javicarrera/Mis-Impresoras3D/Archivos-originales/Melzi board 2.0/melzi-master/README

Melzi Ardentissimo
Based on Sanguinololu

Schematic and board files.

http://reprap.org/wiki/Melzi
