javicarrera/Mis-Impresoras3D/Archivos-originales/README.md

# Archivos originales

Archivo originales de la impresora:
- Instrucciones
- Montaje
- Listado de componentes
- Firmware original
