javicarrera/Mis-Impresoras3D/Cura-perfiles/README.md

# Perfiles de Cura

Perfiles personales para Cura
