javicarrera/Mis-Impresoras3D/Mejoras/README.md

# Mejoras

Mejoras hechas en la impresora, incluyendo piezas 3D y modelos.
Lista de Hardware que lleva montada la impresora, incluyendo
