javicarrera/Mis-Impresoras3D/Modelo3D/README.md

# Modelos 3D

Modelos 3D de la impresora y sus modificaciones
