javicarrera/Mis-Impresoras3D/Archivos-originales/Melzi board 2.0/Melzi-pcb.png

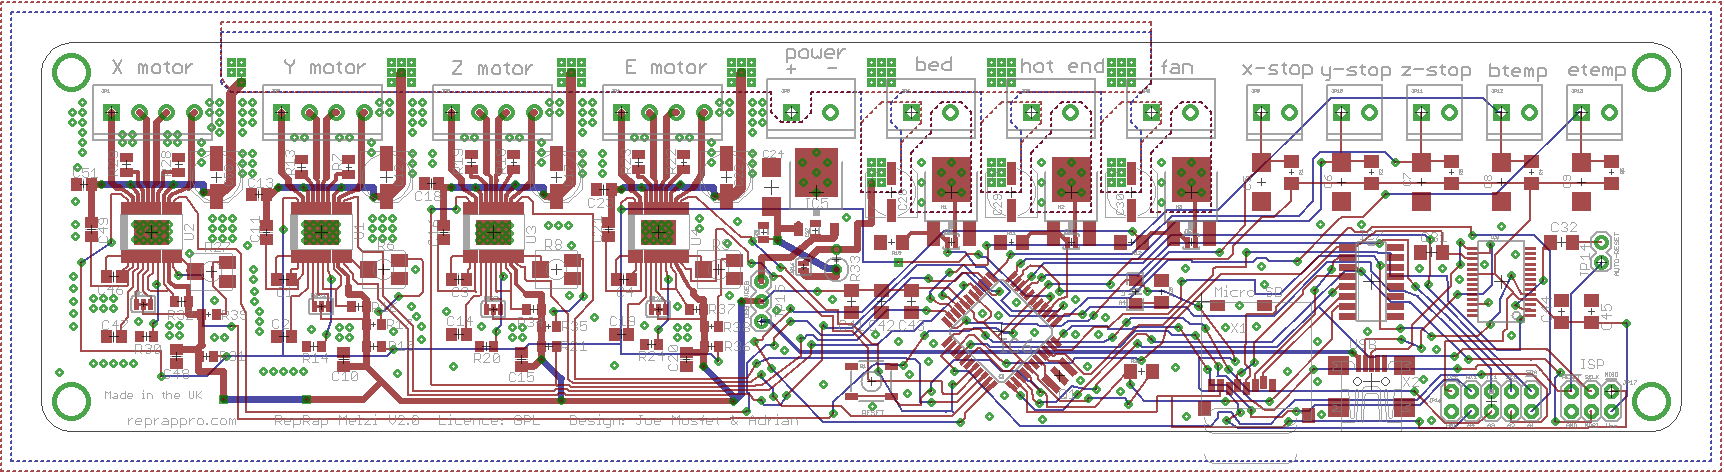
Archivos-originales/Melzi board 2.0/Melzi-pcb.png
