javicarrera/Mis-Impresoras3D/Archivos-originales/X1 Part List(1).pdf

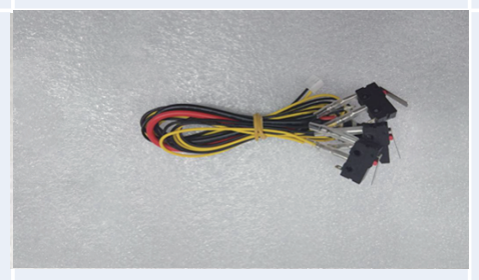
[picture p13: figure]

No. | Picture | Details | Quantity | Check | No. | Picture | Details | Quantity | Check
1-1 | | Limit switch | 3 | | 1-2 | | DC power jack | 1

# X1 Part List

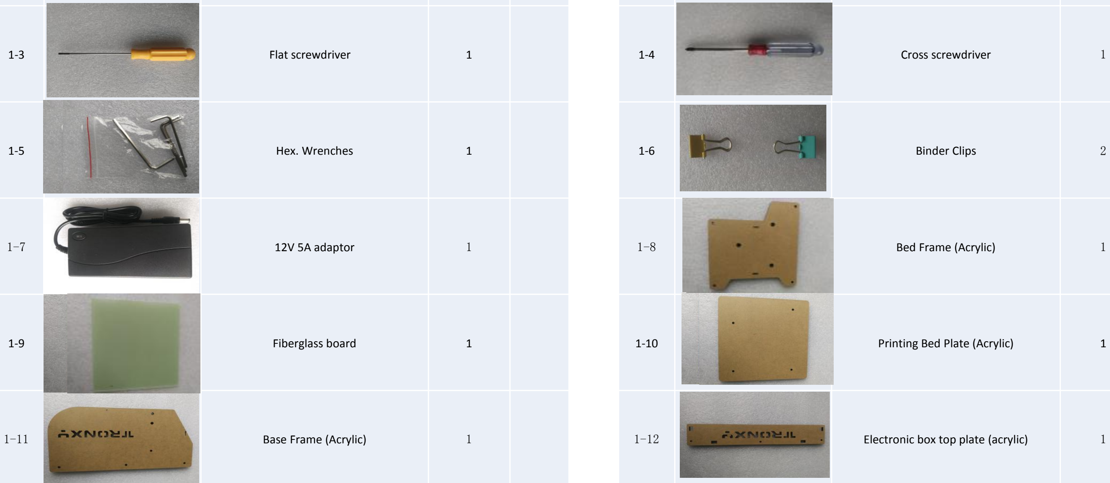
[picture p14: figure]
Flat screwdriver; Cross screwdriver; Hex. Wrenches; Binder Clips; 12V 5A adaptor; Bed Frame (Acrylic); Fiberglass board; Printing Bed Plate (Acrylic); Base Frame (Acrylic); Electronic box top plate (acrylic)
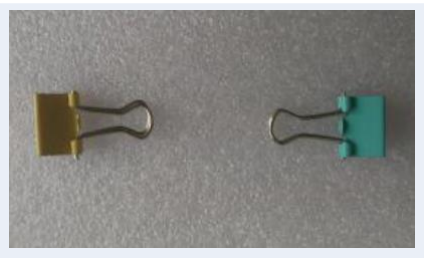
[picture p15: figure]
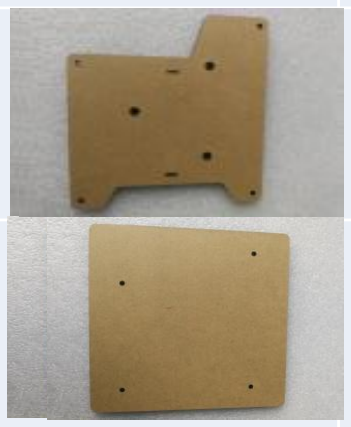
[picture p16: figure]
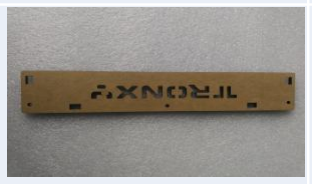
[picture p17: figure]

No. | Picture | Details | Quantity | Check | No. | Picture | Details | Quantity | Check
1-13 | | Electronic box Back plate (acrylic) | 1 | | 1-14 | | Electronic box bottom plate (acrylic) | 1
1-15 | | Electronic box front plate (acrylic) | 1 | | 1-16 | | LCD cable | 1

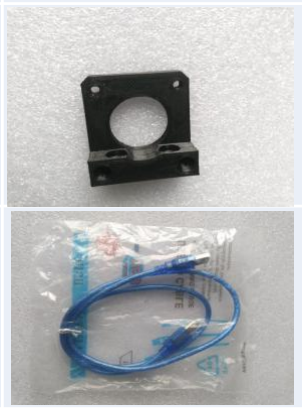
[picture p18: figure]

1-17 | | Electronic box side plate (acrylic) | 2 | | 1-18 | | Z-motor seat | 1
1-19 | | Card reader & Micaro SD card | 1 | | 1-20 | | USB cable | 1
1-21 | | X-motor mount (acrylic) | 1
2-1 | | Extruded bracket | 1 | | 2-2 | | Screws kits | 1
2-3 | | Motor wires | 4 | | 2-4 | | Small acrylic kits | 1

No. | Picture | Details | Quantity | Check | No. | Picture | Details | Quantity | Check

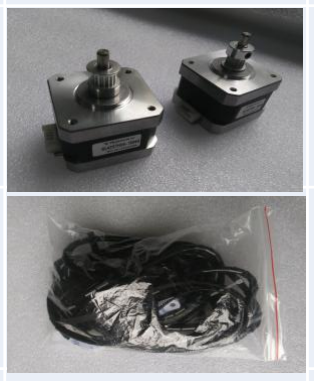
[picture p19: figure]

2-5 | | Z-axis motor (with coupling) | 1 | | 2-6 | | X-axis & Y-axis motors (With Pulley) | 2
2-7 | | Extruder (assembled) | 1 | | 2-8 | | Timing belt x 2pcs Winding pipe Cable ties | 1

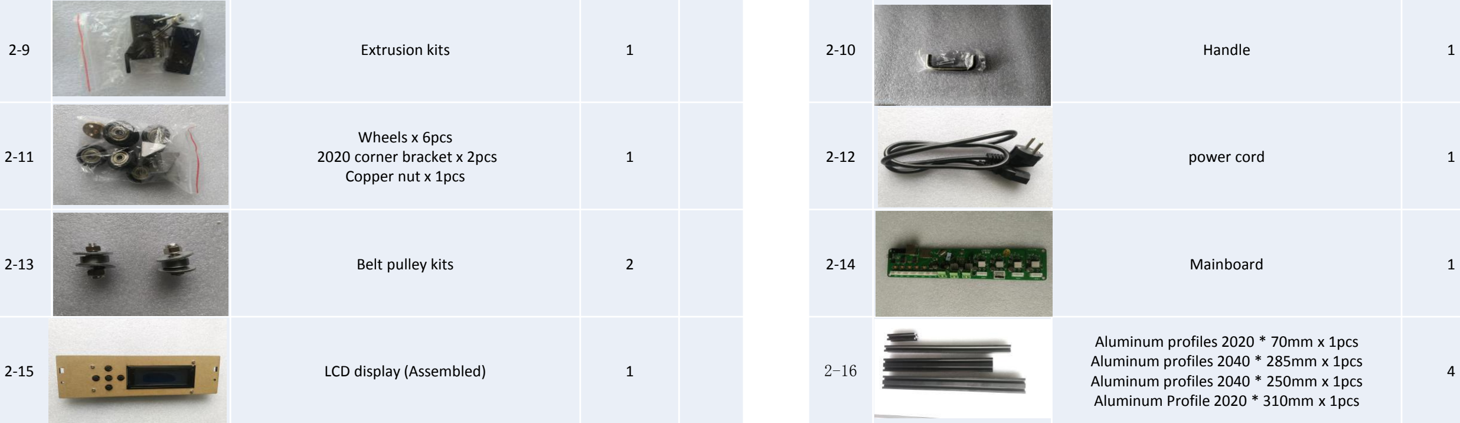
[picture p20: figure]
Extrusion kits; Handle; Belt pulley kits; Mainboard

2-11 | | Wheels x 6pcs 2020 corner bracket x 2pcs Copper nut x 1pcs | 1 | | 2-12 | | power cord | 1

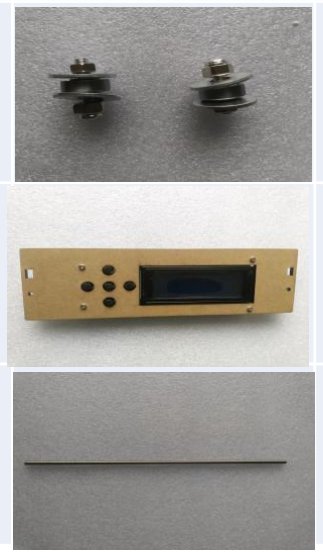
[picture p21: figure]

2-15 | | LCD display (Assembled) | 1 | | 2-16 | | Aluminum profiles 2020 * 70mm x 1pcs Aluminum profiles 2040 * 285mm x 1pcs Aluminum profiles 2040 * 250mm x 1pcs Aluminum Profile 2020 * 310mm x 1pcs | 4
2-17 | | Threaded Rod | 1 | | 2-18 | | Extrusion motor(with gear) | 1
