javicarrera/Mis-Impresoras3D/Archivos-originales/20mm_box_pillar.stl

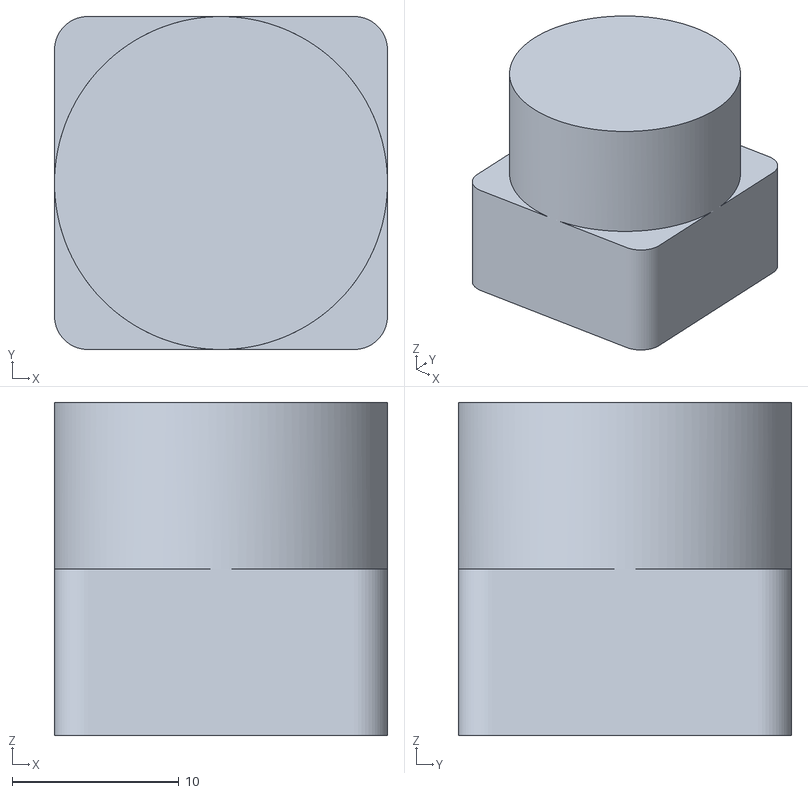
[picture p22: CAD file, 2021-08-16]
Archivos-originales/20mm_box_pillar.stl
20.0 x 20.0 x 20.0
