javicarrera/Mis-Impresoras3D/(list of files, cad)

Other CAD files:
Cura-perfiles/TronXY 45mm-s 0.3mm NoSupport.3mf
Cura-perfiles/TronXY 30mm-s 0.3mm.3mf
