javicarrera/Mis-Impresoras3D/Archivos-originales/Melzi board 2.0/Using an Arduino to Flash the Melzi Board (Wanhao I3) and Upgrade Firmware_ 3 Steps.pdf

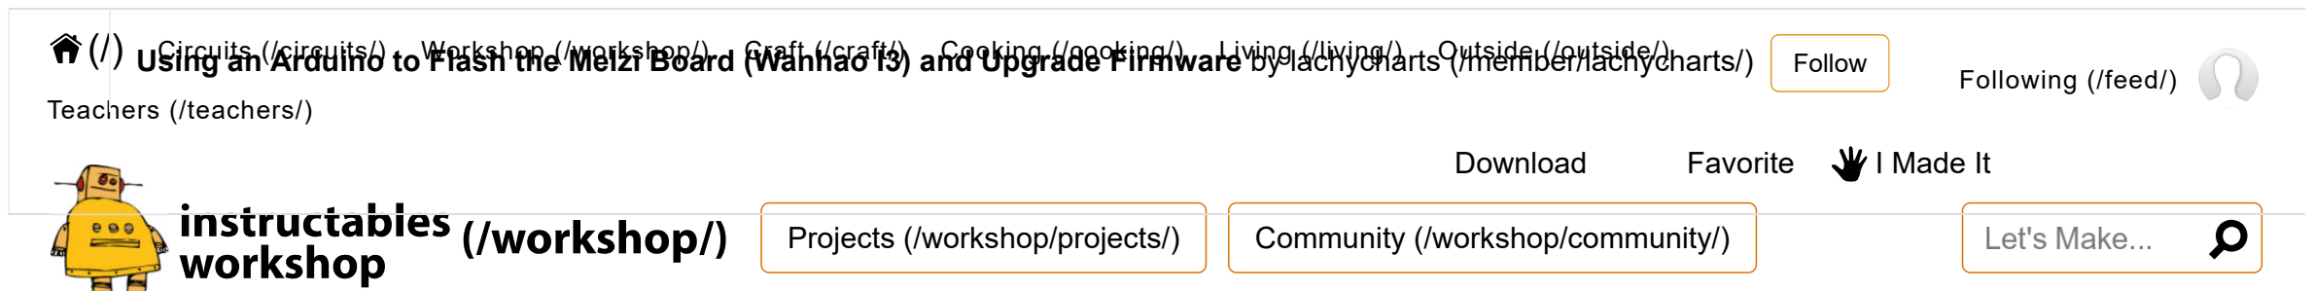
[picture p51: figure]
Circuits (/circuits/); Workshop (/workshop/); Craft (/craft/); Cooking (/cooking/); Living (/living/); Outside (/outside/); Teachers (/teachers/); Following (/feed/); Projects (/workshop/projects/); Community (/workshop/community/); Download; Favorite; I Made It

Published Dec 29th, 2016 | Download | | Favorite

# Using an Arduino to Flash the Melzi Board (Wanhao I3) and Upgrade Firmware

By lachycharts (/member/lachycharts/) in Workshop (/workshop/) > 3D Printing (/workshop/3d-printing/projects/) | 18.678 | 25 | 19

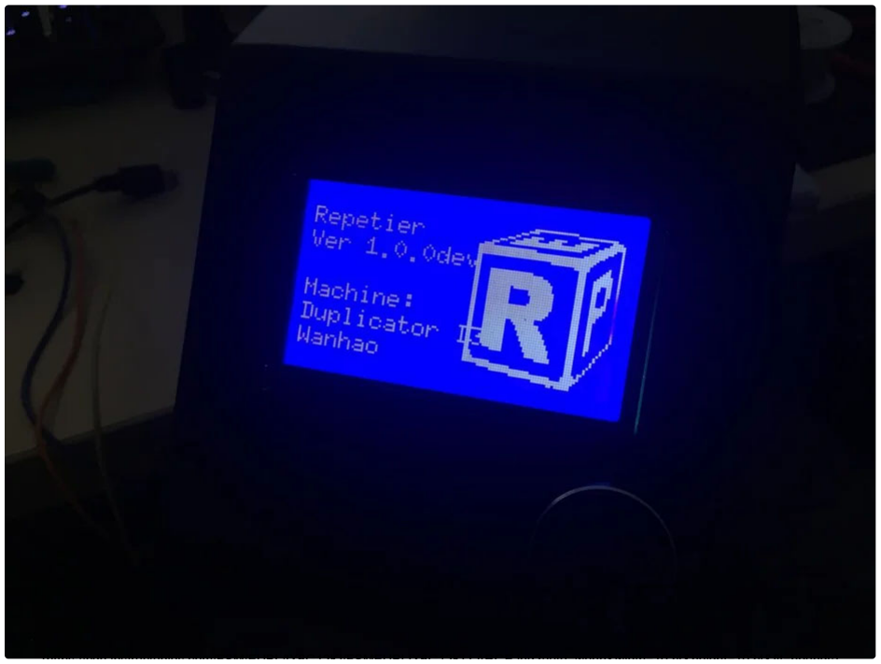
[picture p52: figure]
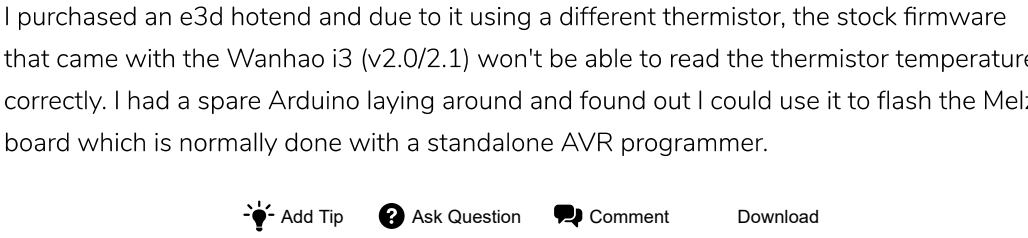
[picture p53: figure]
Add Tip; Ask Question; Comment; Download

# Teacher Notes

### Add Teacher Note

(https://cdn instructables com/FSM/EUBL/IX6G12KI/FSMEUBLIX6G12KI LARGE jpg?auto=webp&width=1024&height=1024&fit=bounds)

Using an Arduino to Flash the Melzi Board (Wanhao I3) and Upgrade Firmware by lachycharts (/member/lachycharts/) Follow

Using an Arduino to Flash the Melzi Board (Wanhao I3) and Upgrade ... | https://www.instructables.com/id/Using-an-Arduino-to-Flash-the-Melz...
1 de 8 | 15/12/2019 16:01

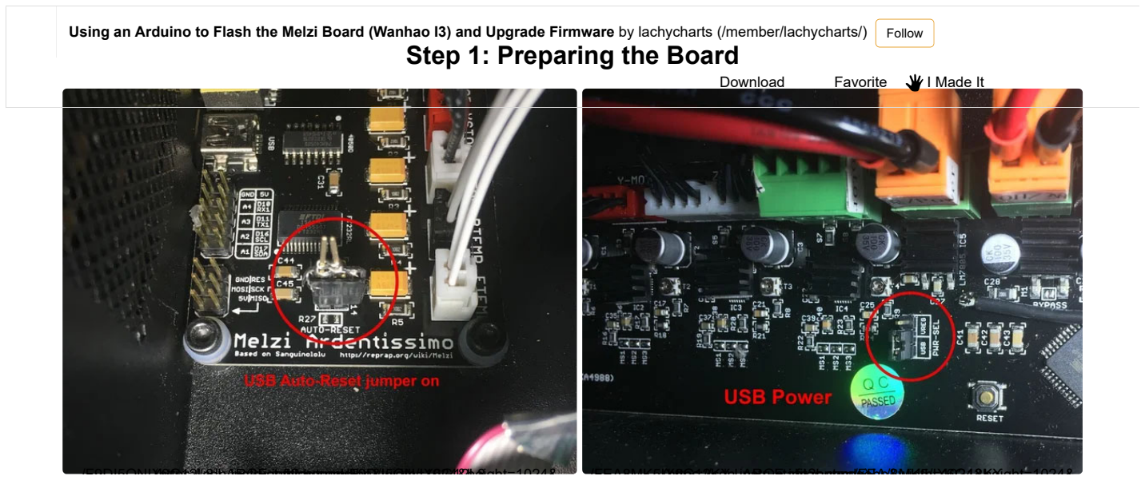
[picture p54: figure]
Step 1: Preparing the Board
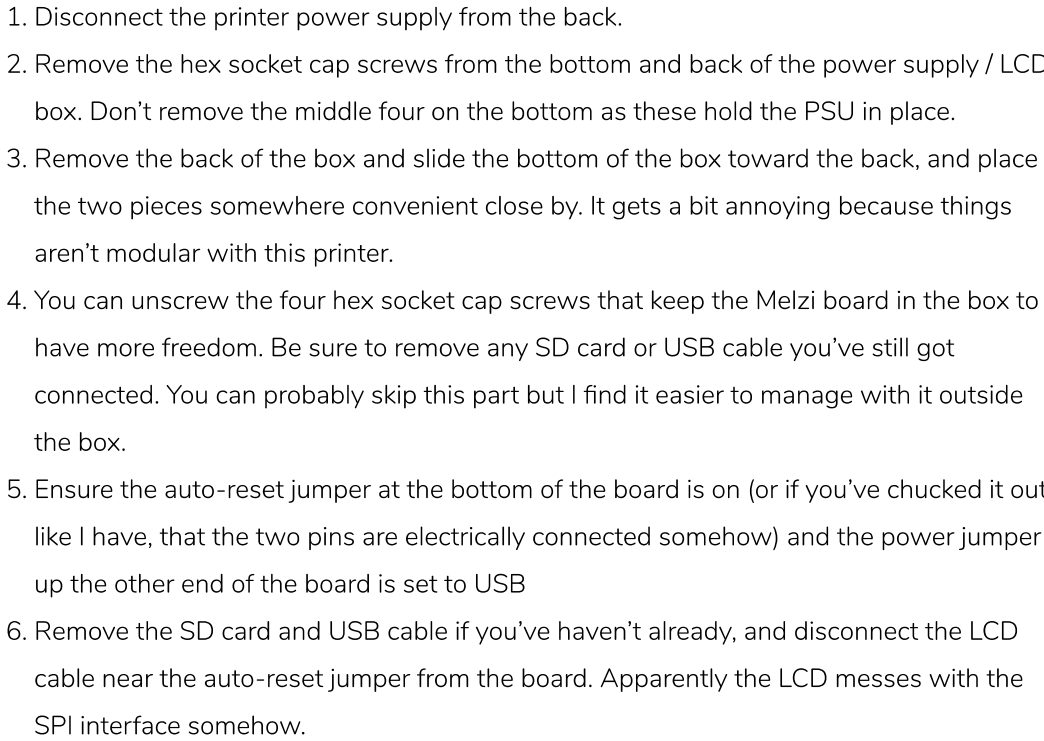
[picture p55: figure]

# Step 2: Preparing the Arduino

/F9DI5ONIX6G12L8 LARGE jpg? (https://cdn instructables com/F9D/I5ON/IX6G12L8 fit=bounds auto=webp&width=1024&height=1024& ) | /FEA8MK5IX6G12KX LARGE jpg?auto (https://cdn instructables com/FEA/8MK5/IX6G12KX fit=bounds =webp&width=1024&height=1024& )
Add Tip | Ask Question | Comment | Download

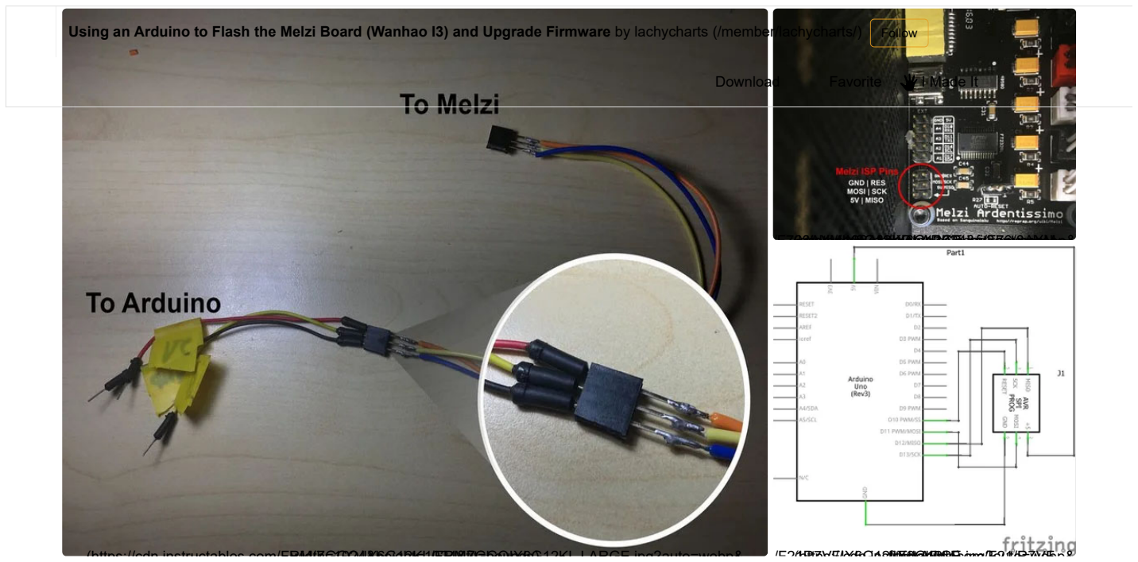
[picture p56: figure]

(https://cdn instructables com/FRM/ZGGQ/IX6G width=1024&height=1024&fit=bounds 12KL/FRMZGGQIX6G12KL LARGE jpg?auto=webp& )

/F768AXMIX6G12KP LARGE jpg?auto=webp& (https://cdn instructables com/F76/8AXM width=1024&height=1024&fit=bounds /IX6G12KP | )

/F21R7VFIX6G12LE LARGE jpg?auto=webp& (https://cdn instructables com/F21/R7VF fit=bounds /IX6G12LE)

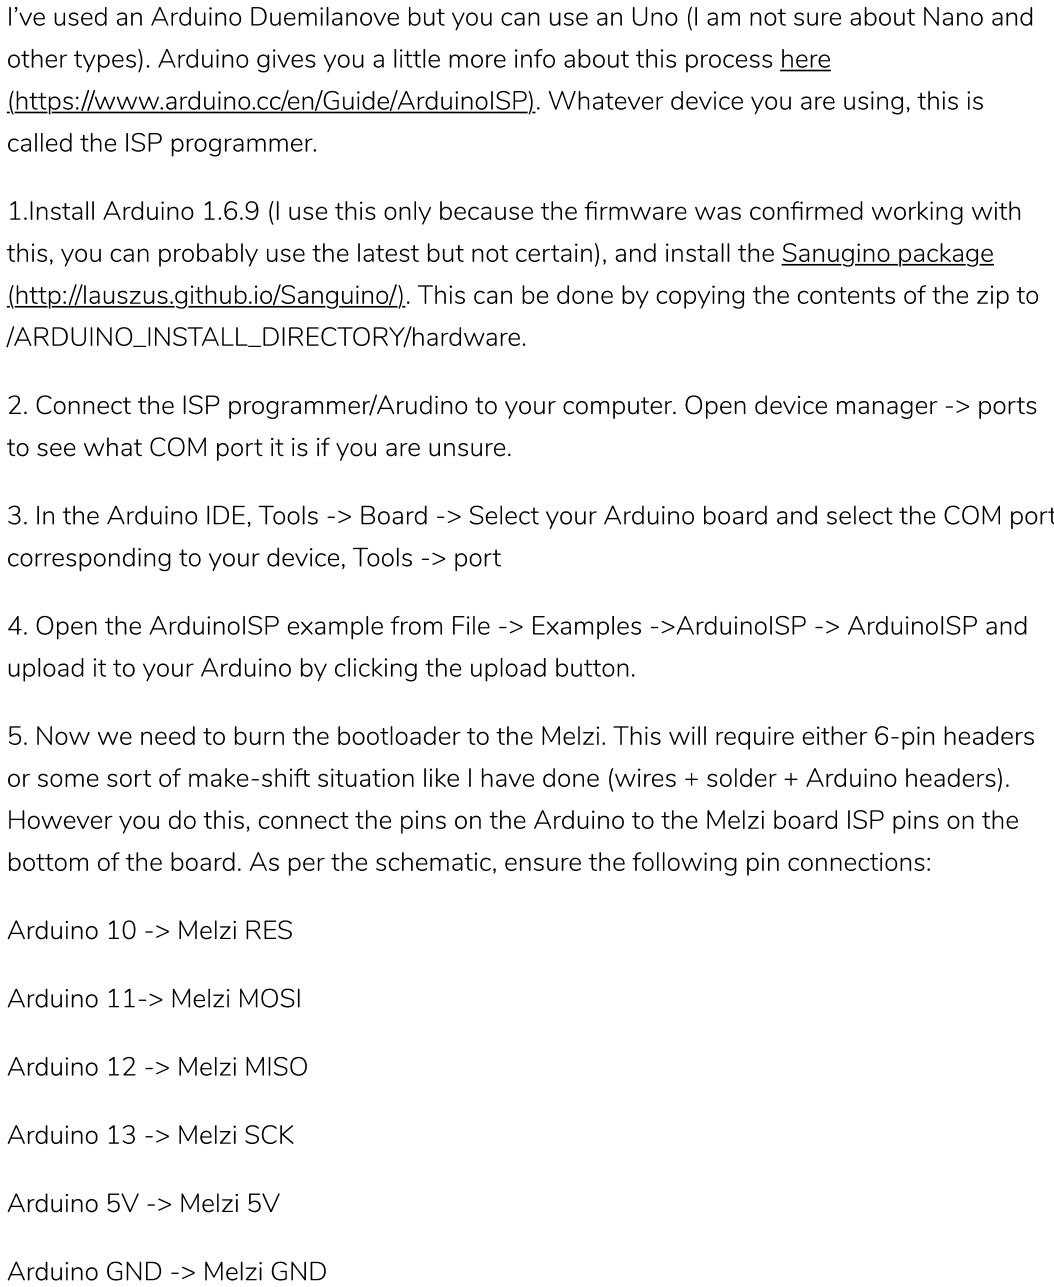
[picture p57: figure]

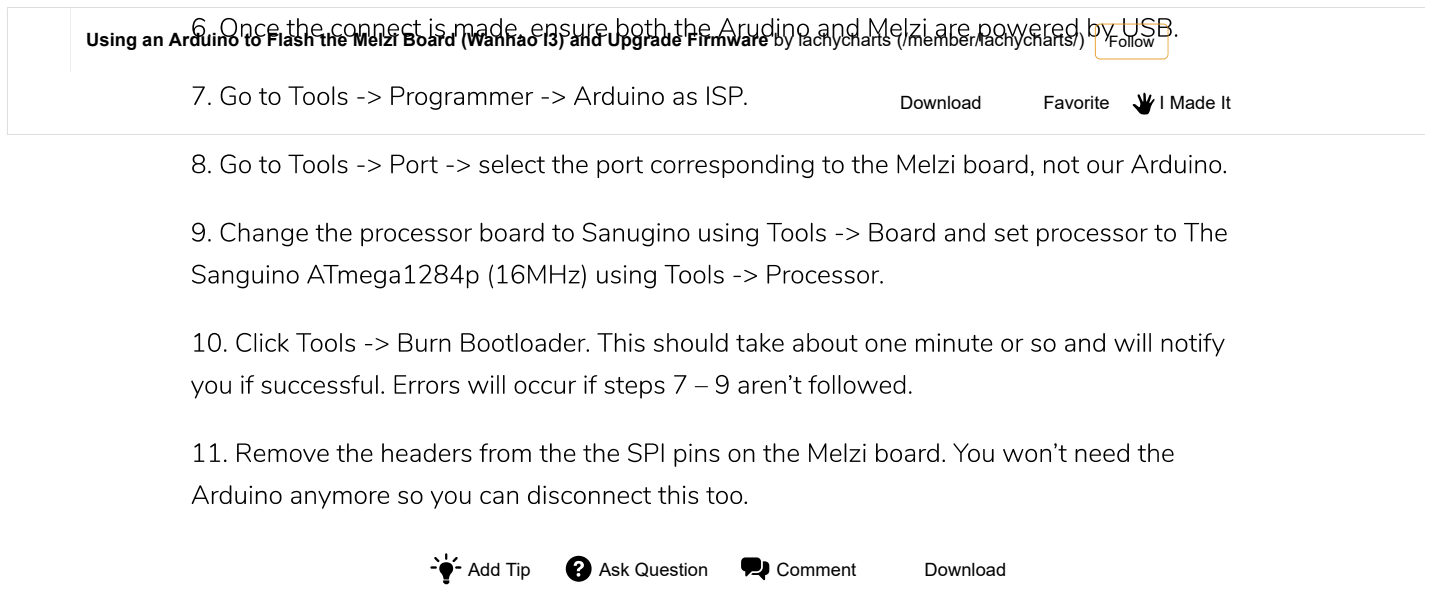
[picture p58: figure]
Add Tip; Ask Question; Comment; Download

# Step 3: The Firmware

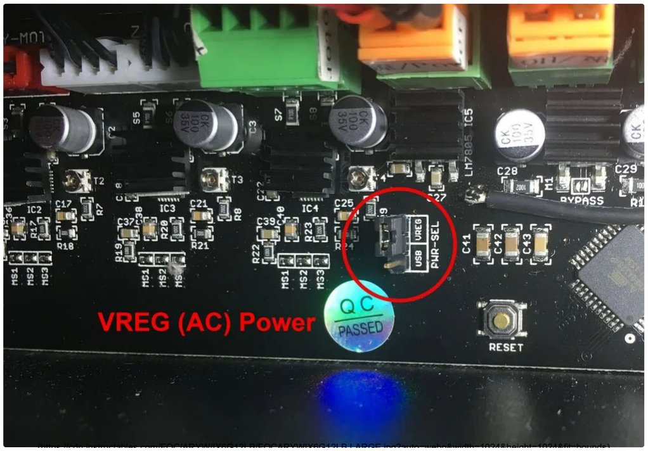
[picture p59: figure]

(https://cdn instructables com/FOC/ARYW/IX6G12LB/FOCARYWIX6G12LB LARGE jpg?auto=webp&width=1024&height=1024&fit=bounds)

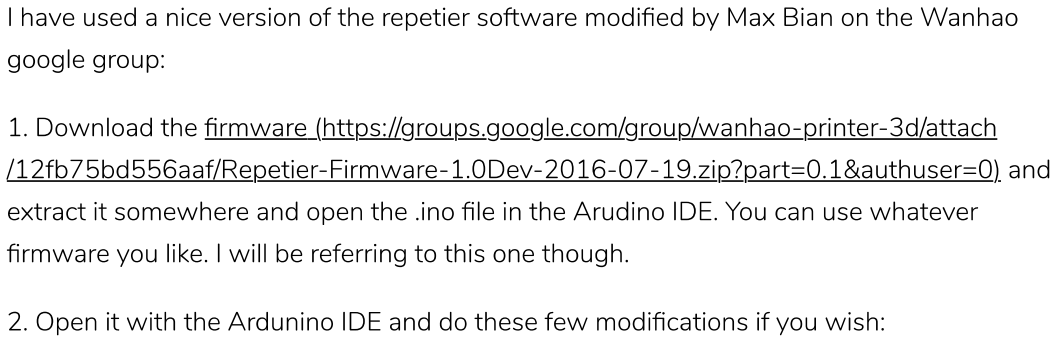
[picture p60: figure]
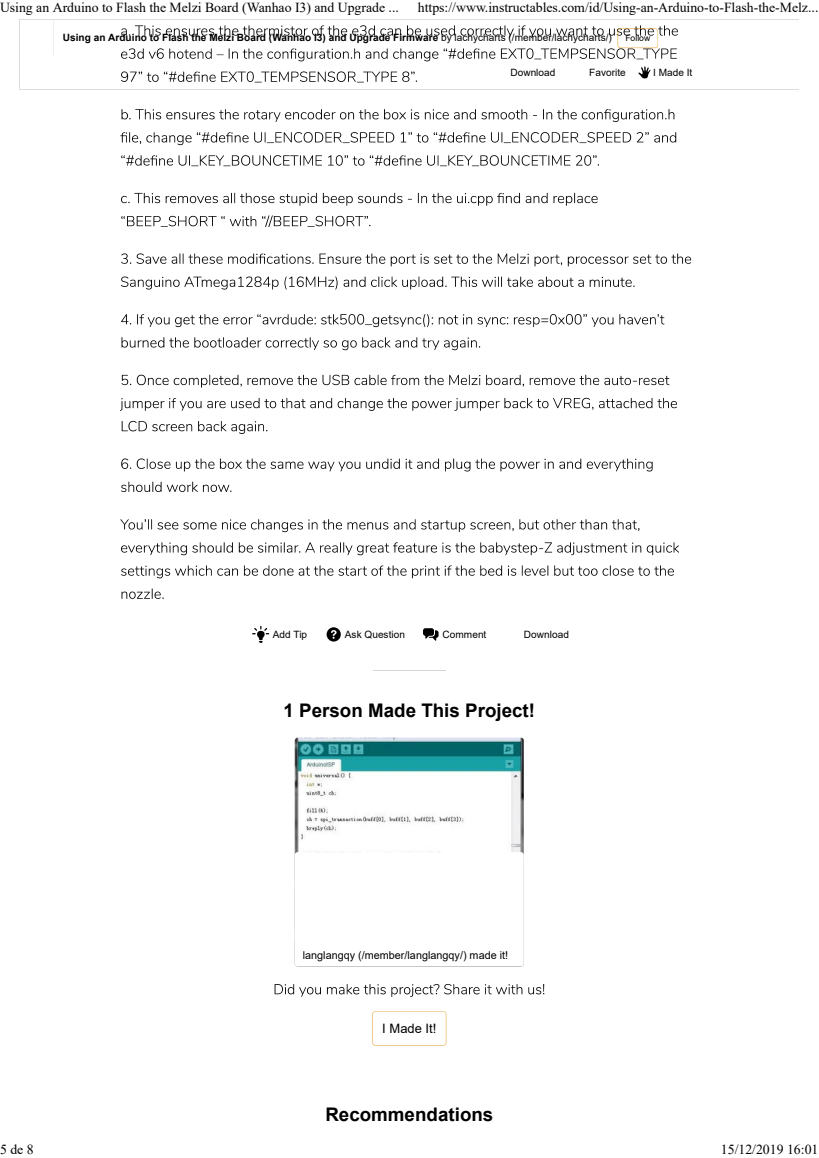
[picture p61: page 5]
I Made It!; Recommendations; Add Tip; Ask Question; Comment; Download

1 Person Made This Project!

langlangqy (/member/langlangqy/) made it!

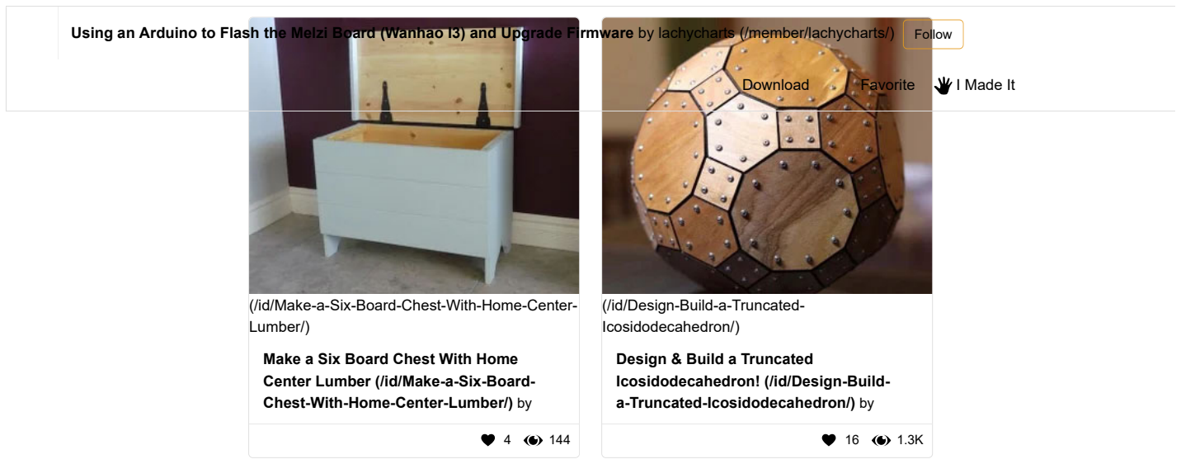
[picture p62: figure]
(/id/Make-a-Six-Board-Chest-With-Home-Center- Lumber/); Make a Six Board Chest With Home Center Lumber (/id/Make-a-Six-Board- Chest-With-Home-Center-Lumber/) by; (/id/Design-Build-a-Truncated- Icosidodecahedron/); Design & Build a Truncated Icosidodecahedron! (/id/Design-Build- a-Truncated-Icosidodecahedron/) by
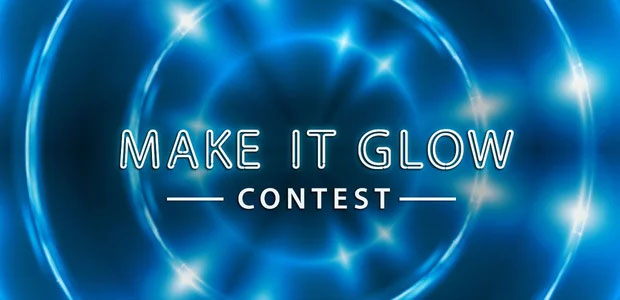
[picture p63: figure]
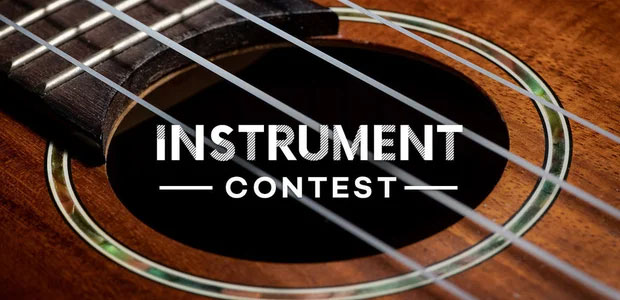
[picture p64: figure]

(/contest/instruments19/) | (/contest/makeitglow19/)

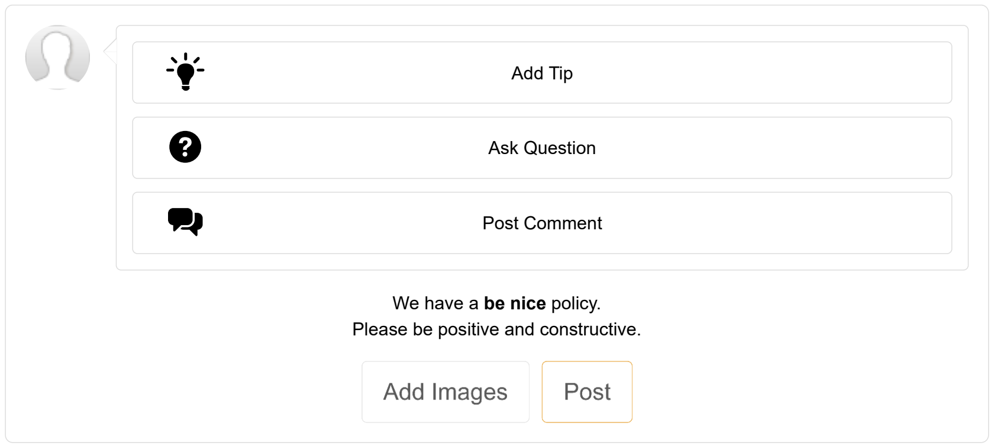
[picture p65: figure]
We have a be nice policy. Please be positive and constructive.; Add Tip; Ask Question; Post Comment

# 19 Discussions

One error in this instructable: In part 8 of step 2 it says to choose the Melzi COM port, but it should say to choose the Arduino port. Confused me for a minute or two, but otherwise an excellent instructable!

1 reply

(/member/RichardE115/) RichardE115 (/member/RichardE115/) a year ago

Reply

1

Upvote

(/member/DanielS1151/) DanielS1151 (/member/DanielS1151/) a year ago

## Post Comment

### After I installed the bootloader I can't connect with Octoprint

### Hi, I tried all you steps, but when trying to load the boot loader, I get these errors: avrdude: stk500_getsync() attempt 4 of 10: not in sync: resp=0x00 avrdude: stk500_recv(): programmer is not responding

2 replies

(/member/G115P/) G115P (/member/G115P/) 2 years ago | Reply | Upvote

Followed this guide and it worked great, thanks! I have a Wanhao Duplicator i3 v2.0, and I noticed after the install that I get idle temps at about 3-7 degrees C and that the hotend temp fluctuates a bit. I think the termistor settings are off. From what I can find on Google I have the 100k 3950 thermistor, do I need to change any configuration values for this to work better? The termistor itself should be ok,

### worked great before the board swap. Ideas?

1 reply

(/member/ErikE40/) ErikE40 (/member/ErikE40/) 3 years ago | Reply | Upvote

### So do you know if this is the newest version of the firmware that is available?

1 reply

(/member/IsaacG57/) IsaacG57 (/member/IsaacG57/) 3 years ago | Reply | Upvote

### Would you recommend this to someone who doesn't have any upgrades as in no aftermarket thermistor or anything? What are the top added setting options available with this?

3 replies

(/member/IsaacG57/) IsaacG57 (/member/IsaacG57/) 3 years ago | Reply | Upvote

So if you didn't want to mess with the firmware you could just use the thermistor that came with the

### Wanhao ? The heater cartridge used seems to be irrelevant to the firmware ? Thanks

3 replies

(/member/glennpiercennwh/) glennpiercennwh (/member/glennpiercennwh/) 3 years ago

Reply | Upvote

### Thanks for sharing :)

(/member/Swansong/) Swansong (/member/Swansong/) 3 years ago | Reply | Upvote

## Categories

## About Us

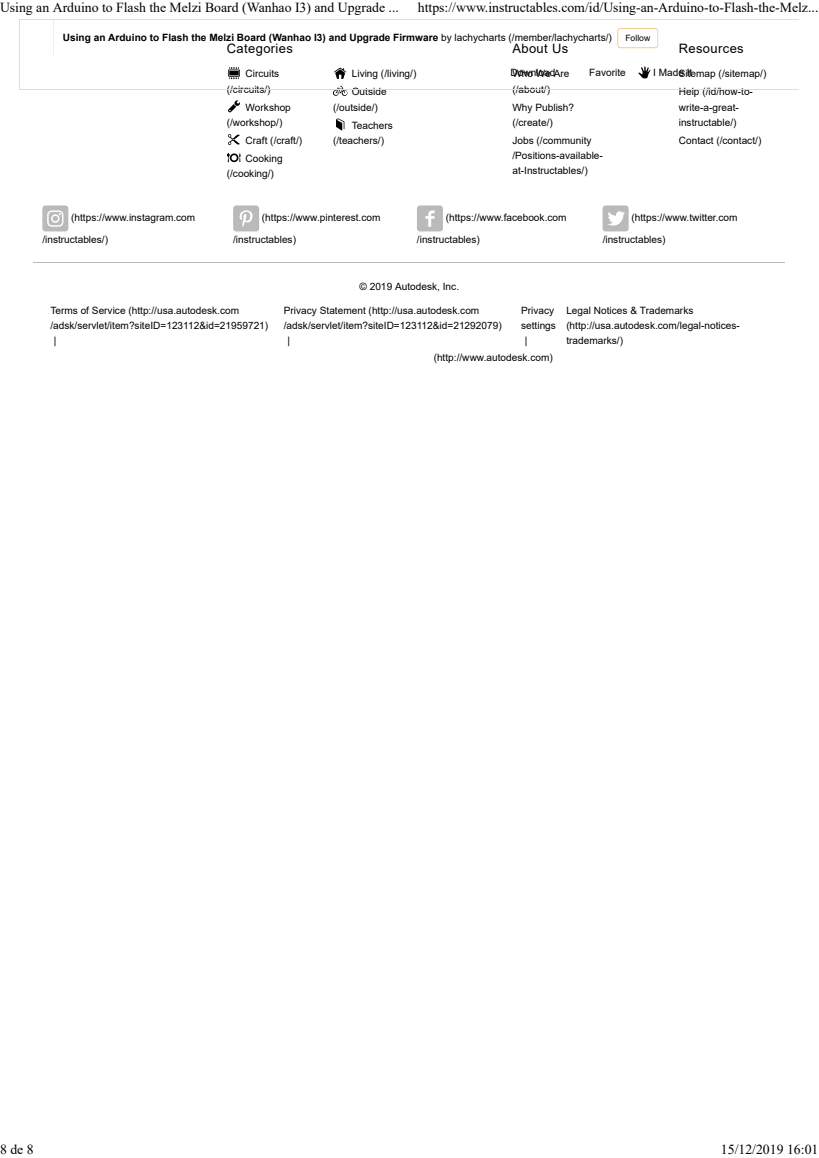
[picture p66: page 8]
Circuits (/circuits/); Workshop (/workshop/); Craft (/craft/); Cooking (/cooking/); Living (/living/); Outside (/outside/); Teachers (/teachers/); Resources; /instructables/); /instructables); © 2019 Autodesk, Inc.; Privacy settings |

Who We Are
(/about/)
Why Publish?
(/create/)
Jobs (/community
/Positions-available-
at-Instructables/)

Sitemap (/sitemap/)
Help (/id/how-to-
write-a-great-
instructable/)
Contact (/contact/)

(https://www.instagram.com

(https://www.pinterest.com

(https://www.facebook.com

(https://www.twitter.com

Terms of Service (http://usa.autodesk.com
/adsk/servlet/item?siteID=123112&id=21959721)

Privacy Statement (http://usa.autodesk.com
/adsk/servlet/item?siteID=123112&id=21292079)

Legal Notices & Trademarks
(http://usa.autodesk.com/legal-notices-
trademarks/)

(http://www.autodesk.com)
