javicarrera/Mis-Impresoras3D/(commit log)

2021-08-16 Tronxy-archivos originales
    [20mm_box_pillar.stl, melzi-bom.csv, melzi-bom.ods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]
2021-08-16 Perfiles de CURA
    [TronXY 30mm-s 0.15mm.csv, TronXY 30mm-s 0.1mm ADAPT-NotSupport.csv, TronXY 30mm-s 0.2mm NotSupport.csv, TronXY 30mm-s 0.3mm.3mf, TronXY 30mm-s 0.3mm.csv, TronXY 40mm-s 0.2mm No Overhangs.csv, TronXY 40mm-s 0.3mm ADAPT 0.1.csv, TronXY 45mm-s 0.3mm NoSupport.3mf]
