javicarrera/Mis-Impresoras3D/(notices)

Notices in the files:
Archivos-originales/Melzi board 2.0/melzi-master/melzi.brd:
reprappro.com RepRap Melzi V2.0 Licence: GPL Design: Joe Mosfet & Adrian
